brunopbb/medidor-ufcg/diagrams/Divisor de Tensão.pdf

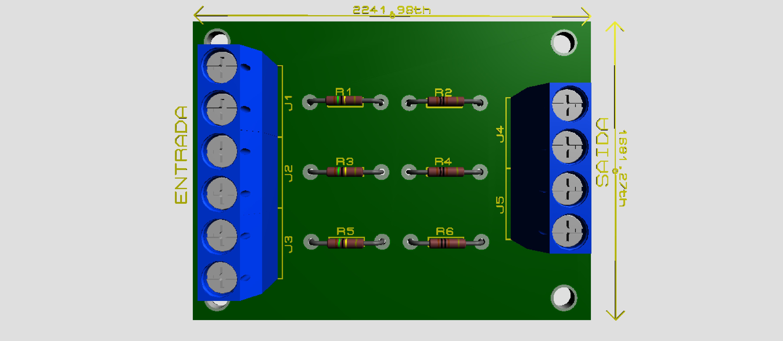
[picture p3: figure]
