brunopbb/medidor-ufcg/diagrams/Placa do Medidor.pdf

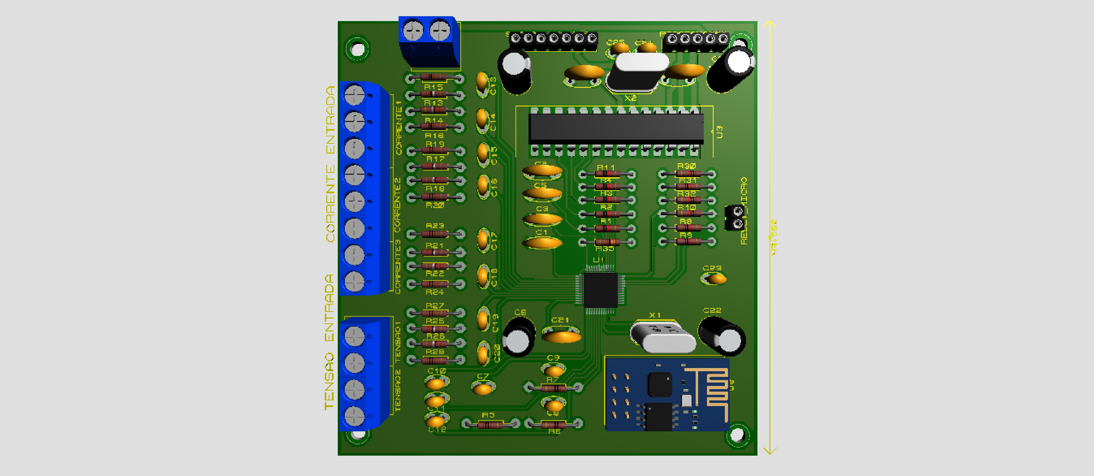
[picture p4: figure]
