brunopbb/medidor-ufcg/images/61Nspo05ELL._AC_SX466_.jpg

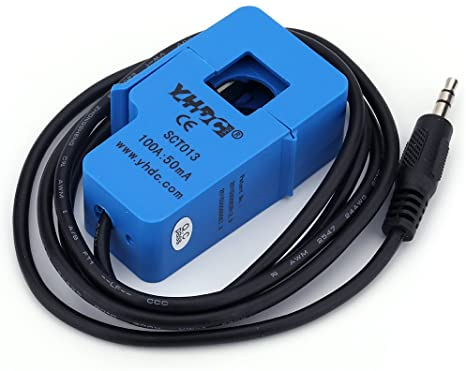
images/61Nspo05ELL._AC_SX466_.jpg
