brunopbb/medidor-ufcg/images/Adaptador USB ESP-01.png

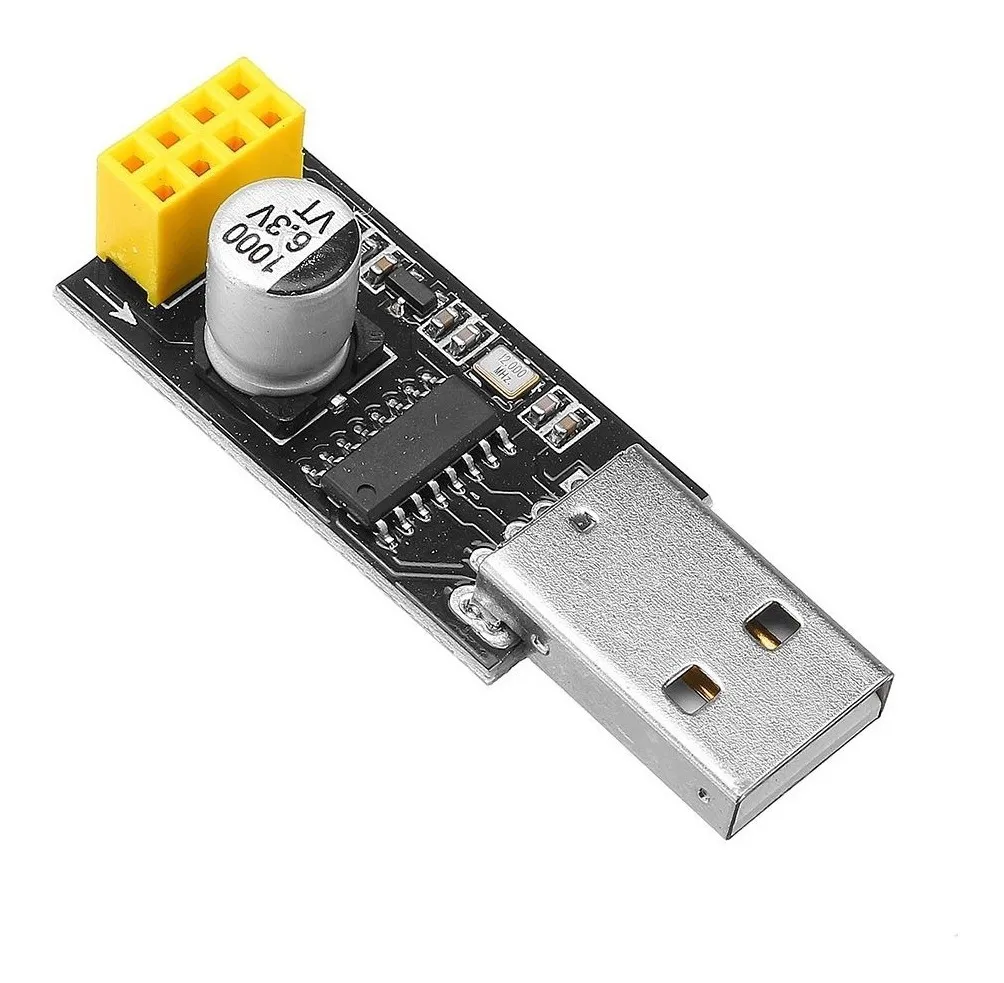
images/Adaptador USB ESP-01.png
