brunopbb/medidor-ufcg/images/ATM90E36A-TQFP-48.png

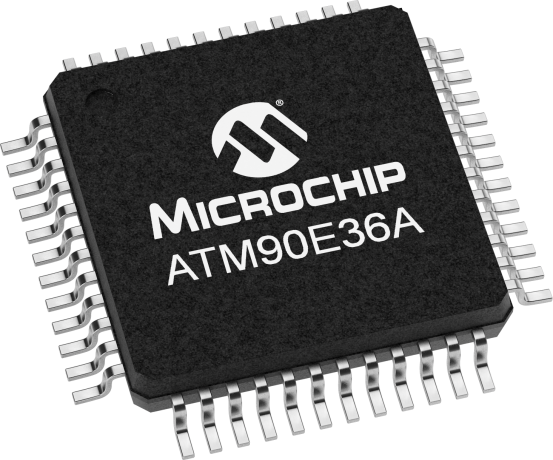
images/ATM90E36A-TQFP-48.png
