brunopbb/medidor-ufcg/images/ATMEGA328P.png

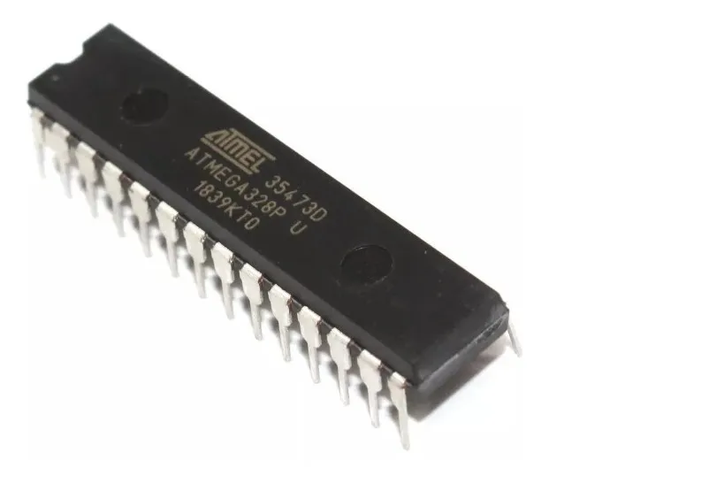
images/ATMEGA328P.png
