brunopbb/medidor-ufcg/images/conversor usb serial cp2102.jpg

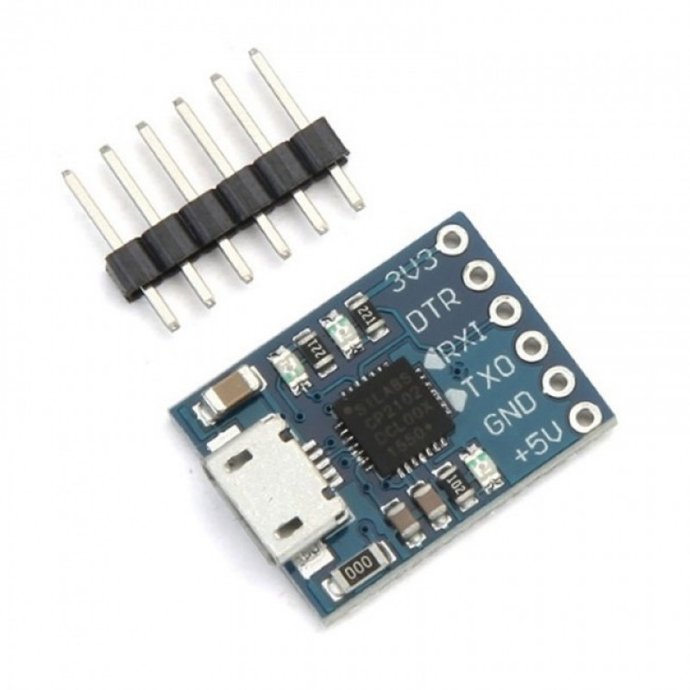
images/conversor usb serial cp2102.jpg
