brunopbb/medidor-ufcg/images/ESP-01.png

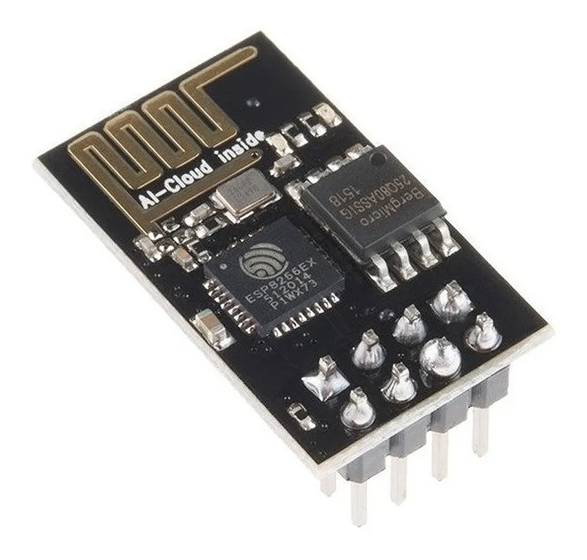
images/ESP-01.png
