brunopbb/medidor-ufcg/images/hlk-pm03_1.jpg

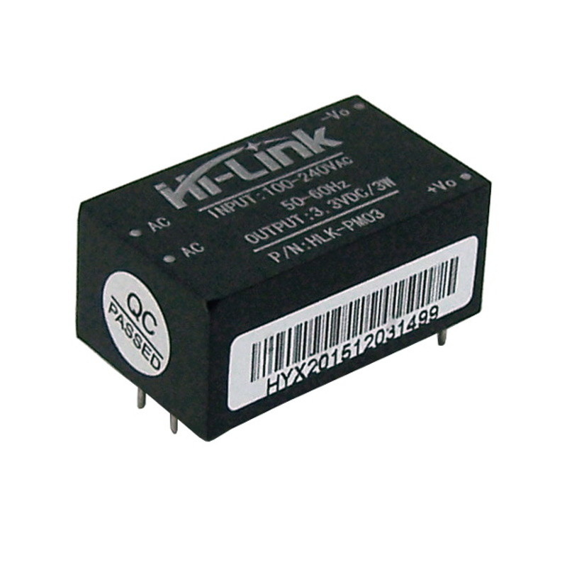
images/hlk-pm03_1.jpg
