brunopbb/medidor-ufcg/diagrams/Esquemático do medidor parte 1.pdf

C5

R1

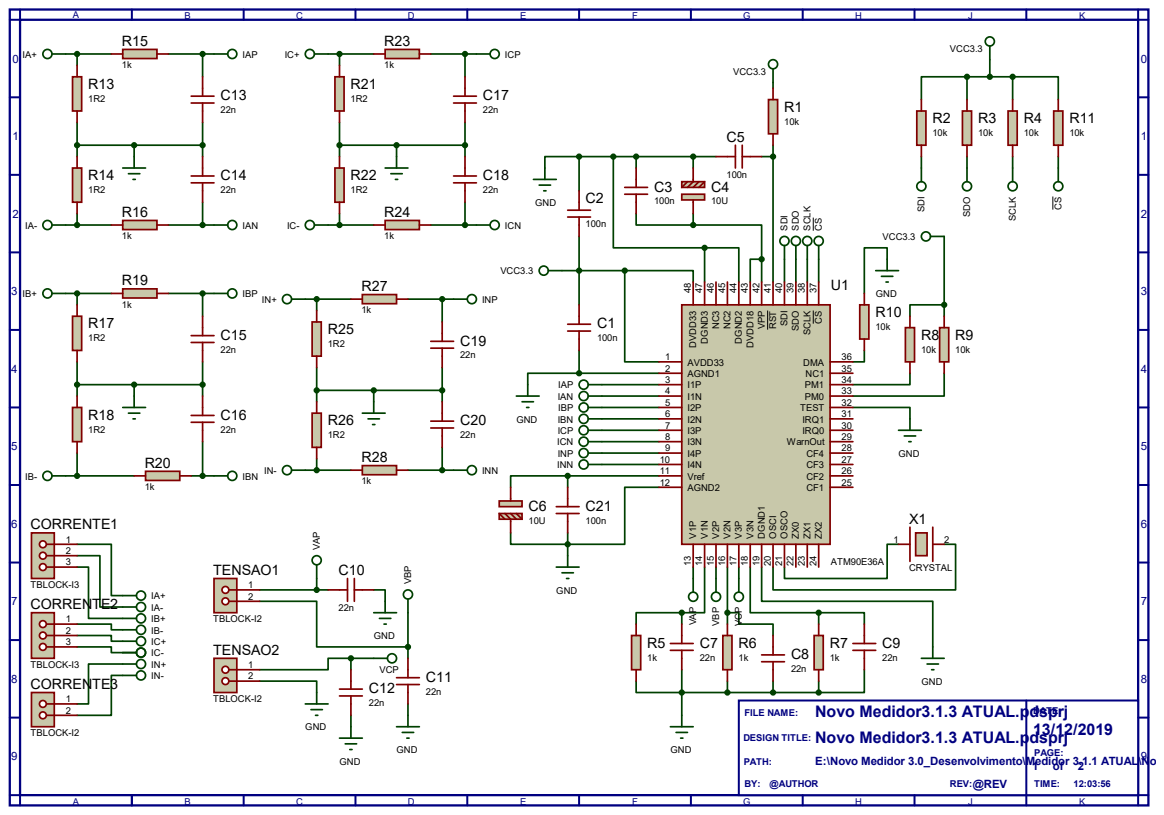
[picture p12: page 1]

FILE NAME:
DESIGN TITLE: Novo Medidor3.1.3 ATUAL.pdsprj
