brunopbb/medidor-ufcg/diagrams/Esquemático do medidor parte 2.pdf

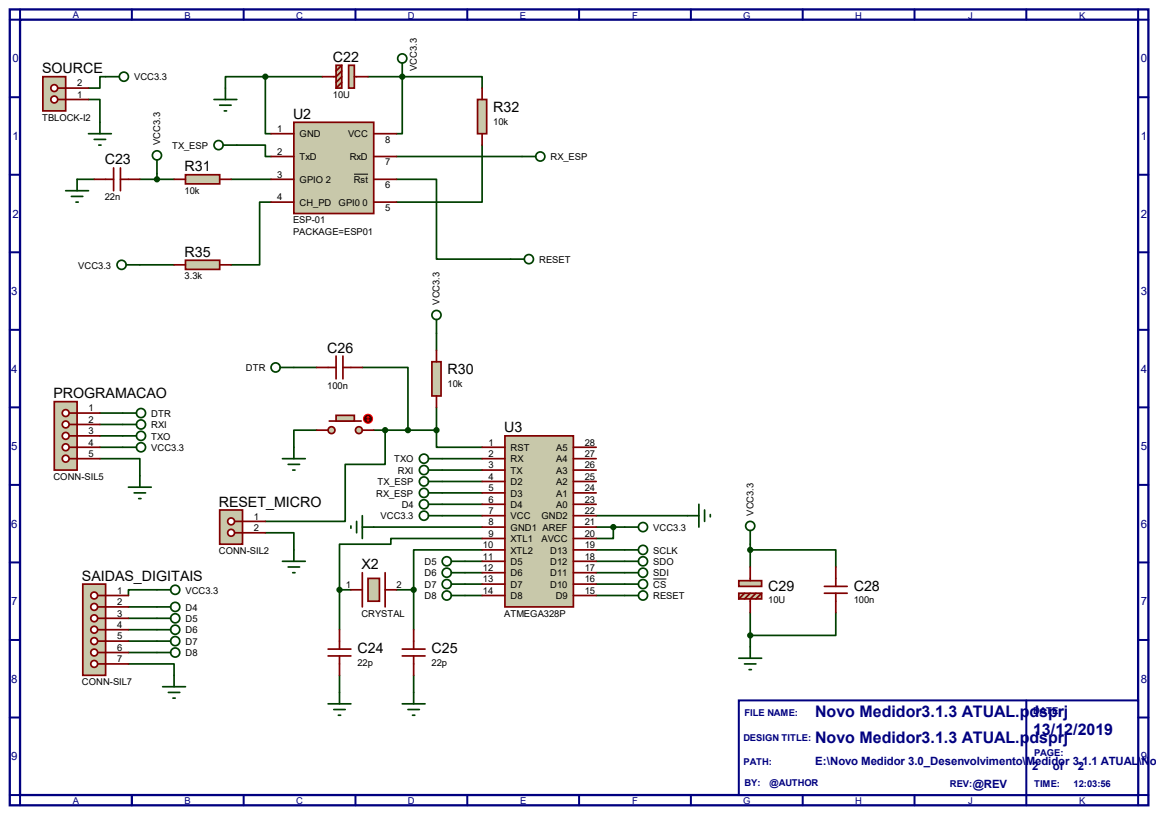
[picture p13: page 1]

FILE NAME:
DESIGN TITLE: Novo Medidor3.1.3 ATUAL.pdsprj
