brunopbb/medidor-ufcg/(commit log)

2026-05-03 Criação da estrutura de projeto, update de firmware via rede, calibração do medidor, integração com grafana
2026-05-03 Revise README for Smart Meter IoT project
    Updated project description and added detailed features, calibration method, and technologies used for the Smart Meter IoT system.
2026-05-07 Correção de BUG
2026-09-13 correção de bugs
2026-09-24 update em funções de reinicialização
2026-10-23 firmware 1.0.27: broker e OTA na rede local
    O medidor da casa passa a falar com o servidor local (bserver) em vez do
    servidor da UFCG. Os enderecos ficam no secrets.h, que nao e versionado;
    aqui muda so a versao e o comentario que documenta a troca.
    Com isso a coleta deixa de depender da internet: uma queda do provedor
    nao gera mais leitura perdida, e os comandos MQTT e o OTA passam a ser
    servidos pela propria rede.
